pcesar22/Voltage-controlled-oscillator/LTSpice-simulation/Schmitt-NMOS.asc

M1: nmos4; modn; l=0.5u w=10u
M2: nmos4; modn; l=0.5u w=10u
M7: nmos4; modn; l=0.5u w=10u
R1: res; 10000k
VD: voltage; 5
vin: voltage; 3
Named nets: 0, VD1, vin, vout1, Vx
.dc vin 0 5 0.01
.include AMS_c35_lib-Level-7_alterado-8.txt
