pcesar22/Voltage-controlled-oscillator/LTSpice-simulation/Schmitt-PMOS.asc

M1: pmos4; modp; l=0.5u w=10u
M2: pmos4; modp; l=0.5u w=10u
M3: pmos4; modp; l=0.5u w=10u
R1: res; 5k
V1: voltage; 0.5
VD: voltage; 5
vin: voltage; 3
Named nets: 0, VD1, vin, vout1, Vy
.dc vin 5 0 0.01
.include AMS_c35_lib-Level-7_alterado-8.txt
