pcesar22/Voltage-controlled-oscillator/LTSpice-simulation/Schmitt-trigger-complete.asc

M1: nmos4; modn; l=2.4u w=2.4u
M2: nmos4; modn; l=2.4u w=2.4u
M3: nmos4; modn; l=2.8u w=6.6u
M4: pmos4; modp; l=1.2u w=4.8u
M5: pmos4; modp; l=1.2u w=4.8u
M6: pmos4; modp; l=1.2u w=10.8u
VD: voltage; 5
vin: voltage; PWL file=values.txt
Named nets: 0, VD1, vin, Vx, vout1, Vy
.include AMS_c35_lib-Level-7_alterado-8.txt
.tran 7
