pcesar22/Voltage-controlled-oscillator/LTSpice-simulation/VCO-final.asc

C1: cap; 1p
M1: nmos4; modn; l=2.4u w=2.4u
M2: nmos4; modn; l=2.4u w=2.4u
M3: nmos4; modn; l=2.8u w=6.6u
M4: pmos4; modp; l=1.2u w=4.8u
M5: pmos4; modp; l=1.2u w=4.8u
M6: pmos4; modp; l=1.2u w=10.8u
M7: pmos4; modp; l=0.5u w=10u
M8: pmos4; modp; l=0.5u w=10u
M9: nmos4; modn; l=0.5u w=4u
M10: nmos4; modn; l=0.5u w=4u
M11: nmos4; modn; l=0.5u w=10u
M12: pmos4; modp; l=0.5u w=10u
M13: pmos4; modp; l=0.5u w=10u
M14: nmos4; modn; l=0.5u w=10u
VD1: voltage; 5
vin1: voltage; 1
Named nets: 0, VD1, vin, Vx, Vy, vout
.include AMS_c35_lib-Level-7_alterado-8.txt
.tran 0 5e-7 0 1e-9
